upenn-embedded/final-project-website-submission-f25-t28-f25-minus-5/Slides/ESE5190 F25 Final Project Proposals.pptx.pdf

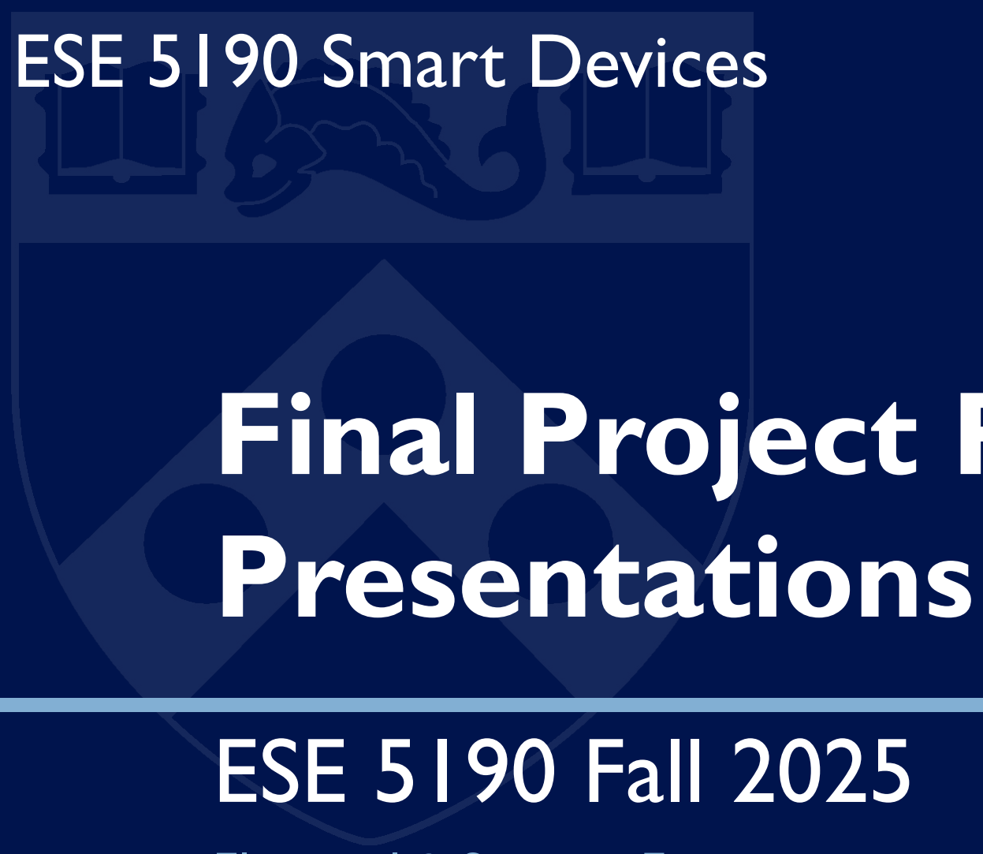
[picture p5: figure]
Presentations; ESE 5190 Fall 2025; ESE 5190 Smart Devices

# Final Project Proposal

Electrical & Systems Engineering University of Pennsylvania

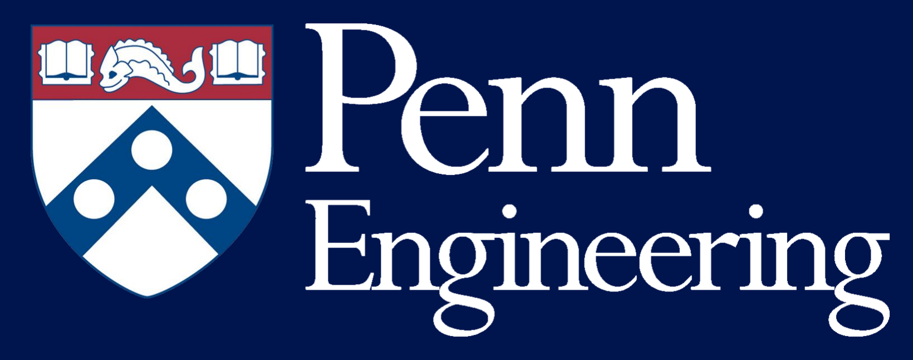
[picture p6: figure]

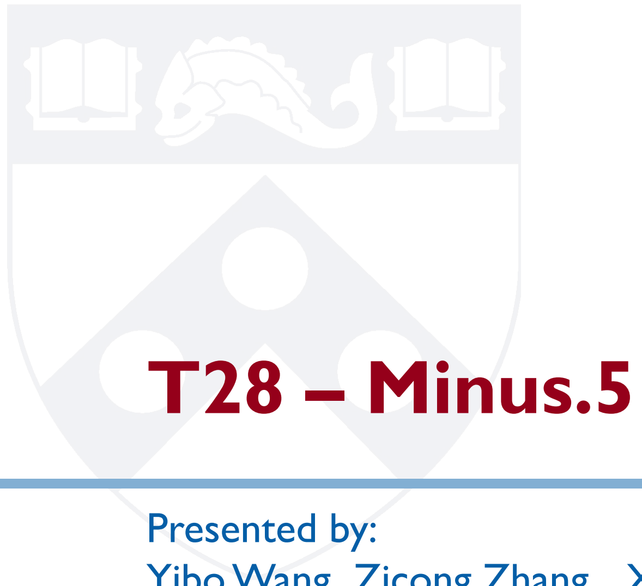
[picture p7: figure]
T28 – Minus.5; Presented by:

### Yibo Wang Zicong Zhang Xiuwen Zheng

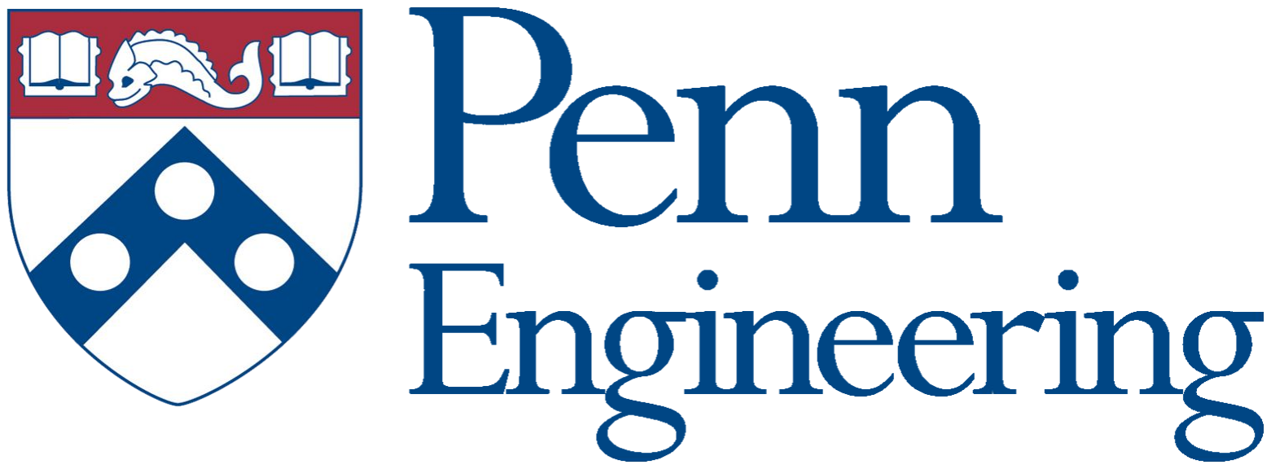
[picture p8: figure]

# Questions!

### How many people know what is a guitar?

### How many of you know how to play a guitar?

## Can you imagine that you could play guitar solos and sing along —without ever learning a single chord?

# Now!

# Making the impossible possible!

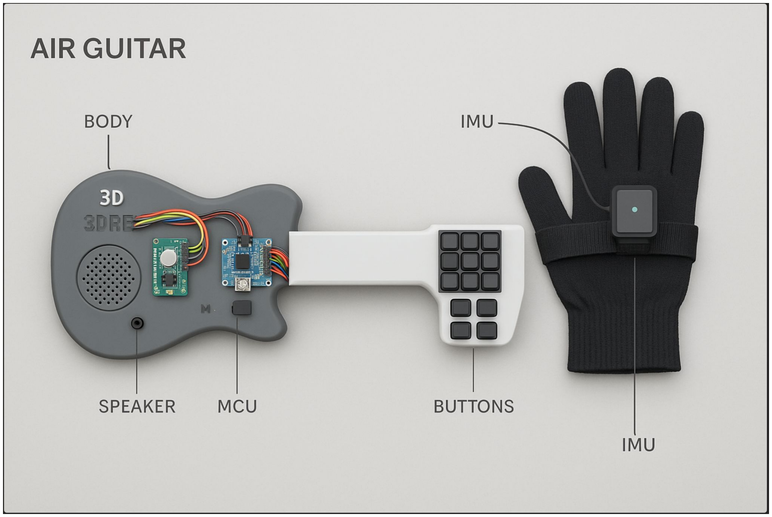
[picture p9: figure]

## The AirGuitar

# We shall introduce to you

Notice:
AI-generated concept rendering. Final appearance subject to physical build and implementation.

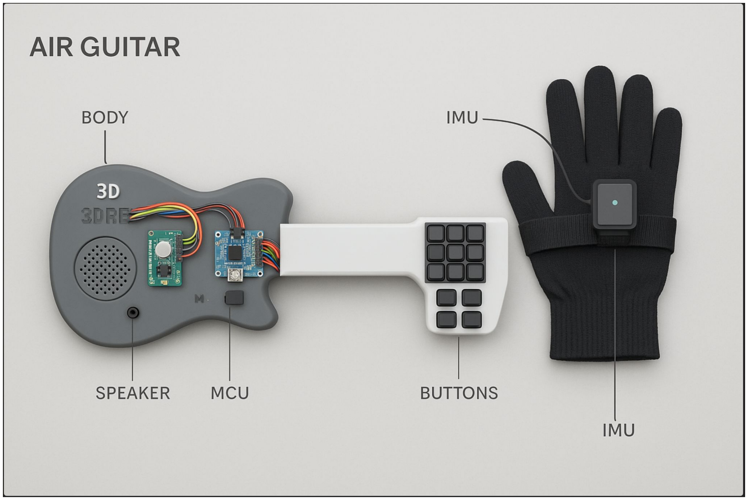
[picture p10: figure]

## The AirGuitar

# We shall introduce to you

Simplifies everything:

- Fixed chord mappings

—always makes great
sound

## The AirGuitar

# We shall introduce to you

Simplifies everything:

- IMU-based
strumming—natural
gestures, no strings
required.

## The AirGuitar

# We shall introduce to you

Simplifies everything:

- “Auto-play” key—press
once to auto-cycle
chords and sing along.

## The AirGuitar

# We shall introduce to you

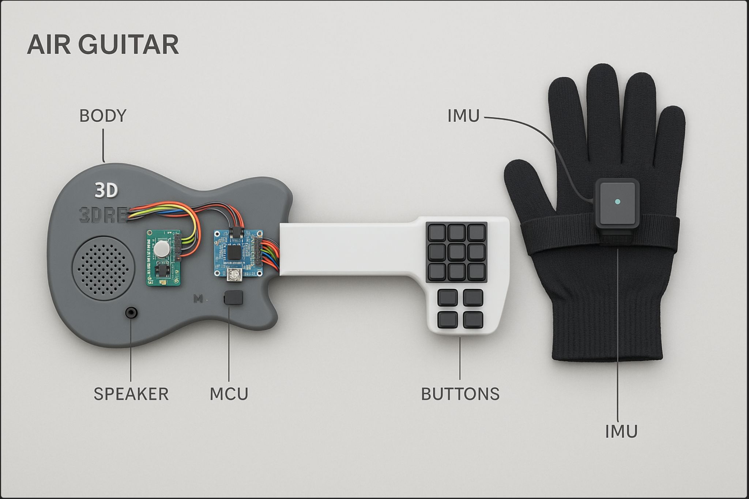
[picture p11: figure]

## Simple!

## Accessible!

## Fun!

## Music for everyone!

# New Era for enjoying music!

Low-cost on-ramp to
music-making; less
pressure, more joy.

Useful for music
education, therapy, and
quick prototyping of song
ideas.

Socially sticky: instant
accompaniment for
singers;
yes, potentially a low-effort way to “impress your
crush.

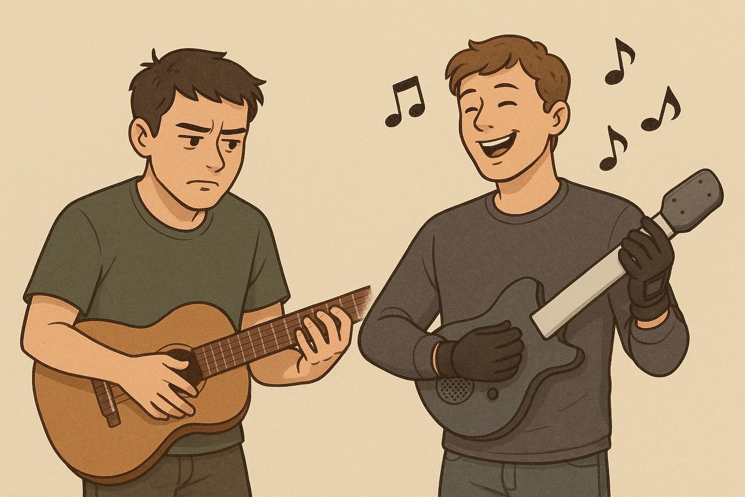
[picture p12: figure]

## Accessible, Interactive, Creative, and Inspirational

—turn hesitation into participation.

# System Block Diagram

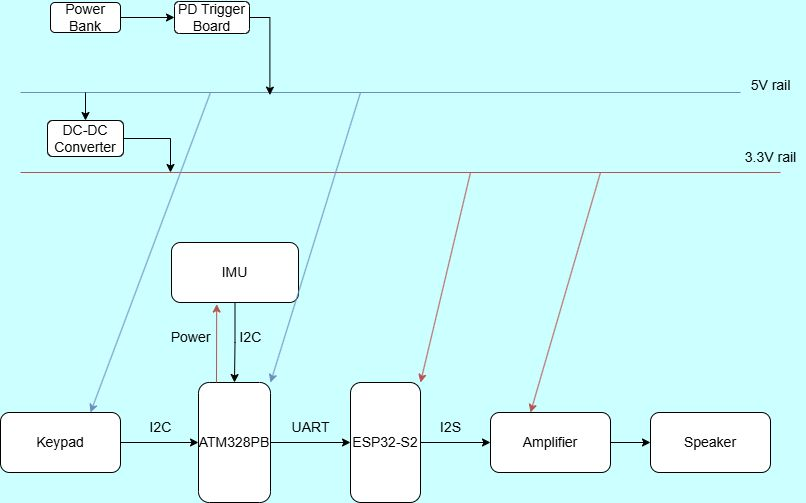
[picture p13: figure]

Input Side

- Keypad (I²C) → chord selection
- IMU (I²C) → detects strumming gestures
- ATmega328PB → processes both inputs and sends data to ESP32 via UART

Output Side

- ESP32-S2 → generates corresponding guitar sounds
- I²S → digital audio to amplifier, then speaker

Power

- 5V output from PD trigger board, regulated to 3.3V via Buck-Boost.

# Play a compact, light, portable “Guitar”

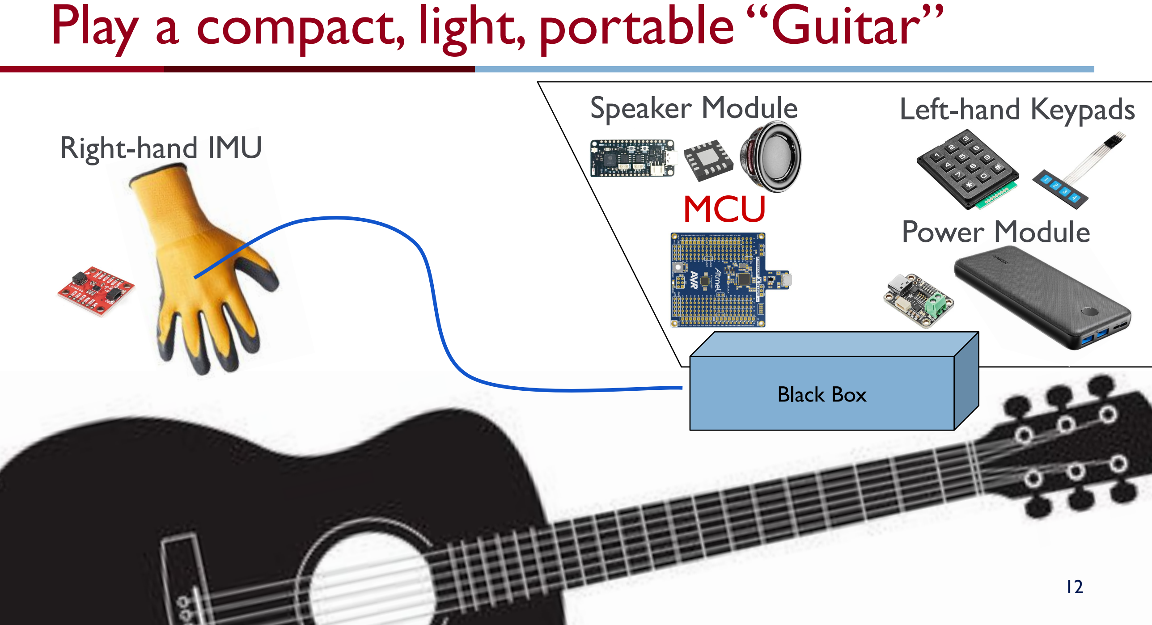
[picture p14: page 12]

### Right-hand IMU

### Speaker Module

## MCU

### Left-hand Keypads

### Power Module

Black Box

# Play it without knowing how to play the guitar

Right-hand IMU | Left-hand Keypads

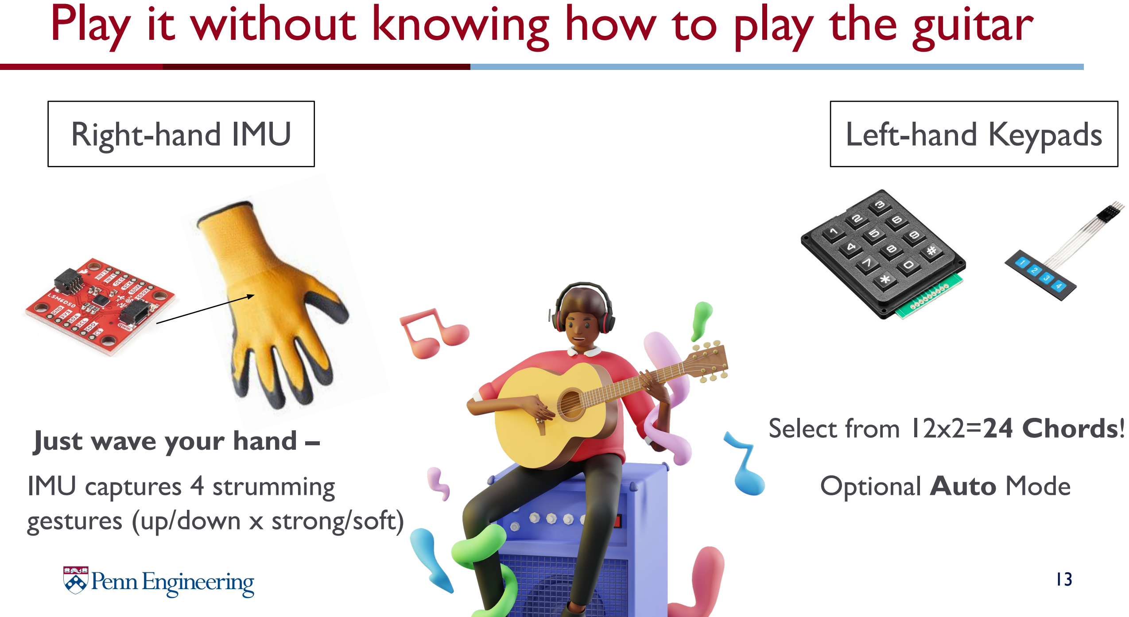
[picture p15: page 13]

Select from 12x2=24 Chords!

| Optional Auto Mode

Just wave your hand –
IMU captures 4 strumming
gestures (up/down x strong/soft)

# Inspire your friends with high-quality music!

## Speaker Module

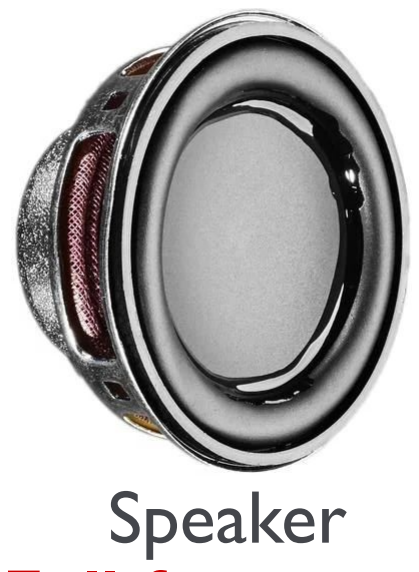
[picture p16: figure]
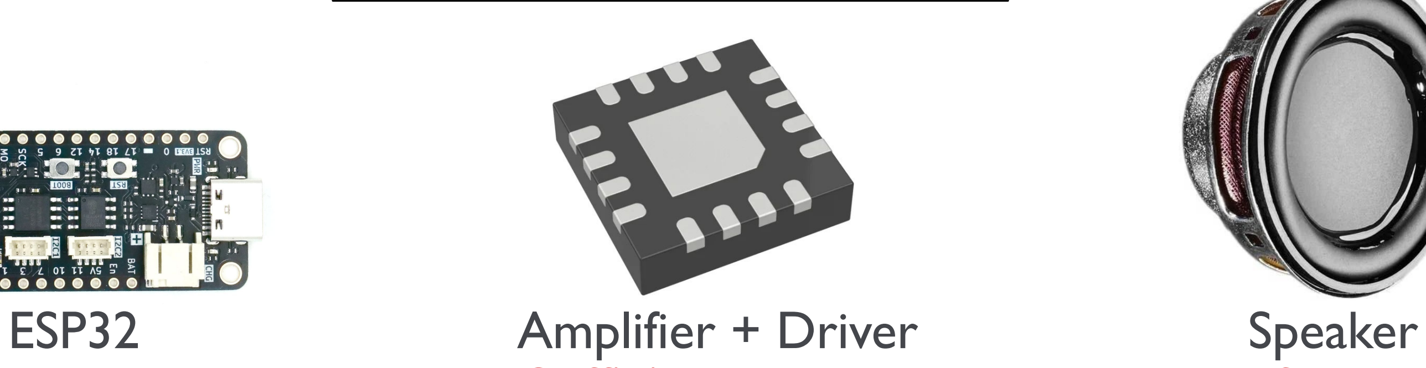
[picture p17: figure]
ESP32; Amplifier + Driver; Speaker
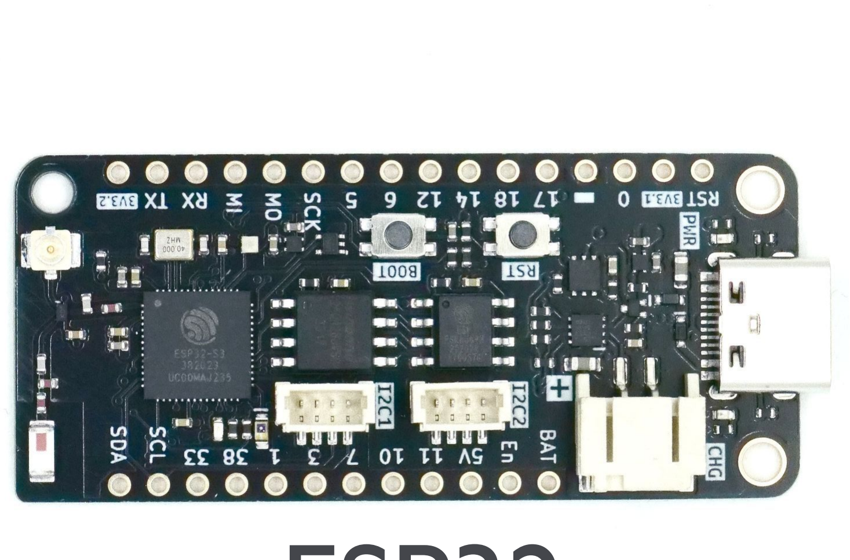
[picture p18: figure]

Low latency | Sufficient Volume | Full-frequency

### Amy: A Music Synthesizer Library

Emulate sound of a real guitar

Simple.
Effective.
Transformative.

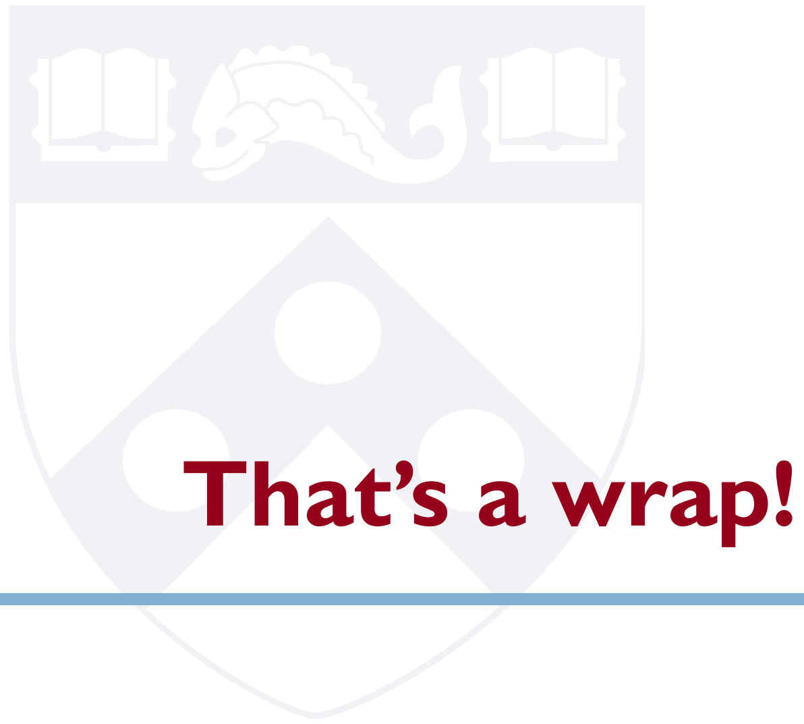
[picture p19: figure]
That’s a wrap!
