upenn-embedded/final-project-website-submission-f25-t28-f25-minus-5/Miscellaneous/Guitar Sheets/Beyond/IMG_2863.jpg

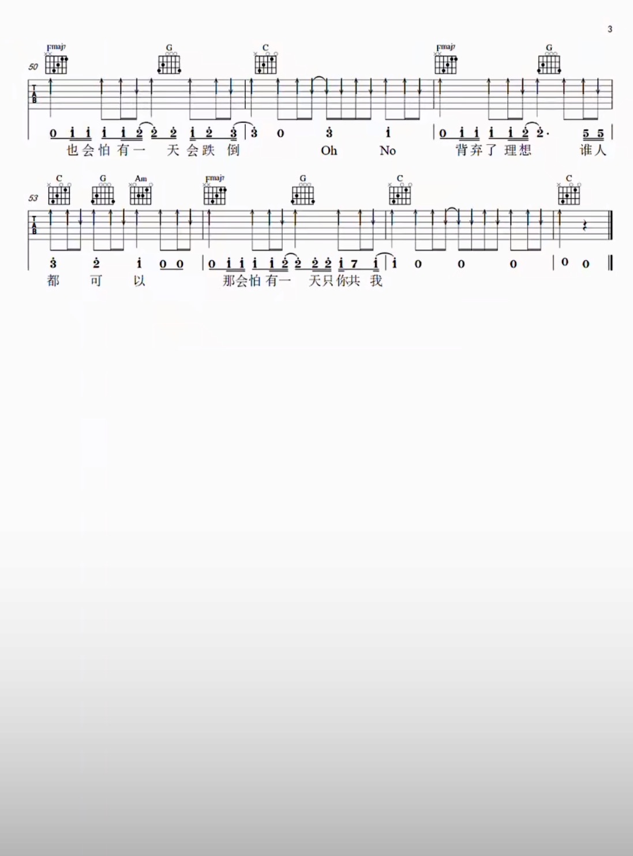
Miscellaneous/Guitar Sheets/Beyond/IMG_2863.jpg
