upenn-embedded/final-project-website-submission-f25-t28-f25-minus-5/Miscellaneous/Guitar Sheets/Jay Chow/IMG_2865.PNG

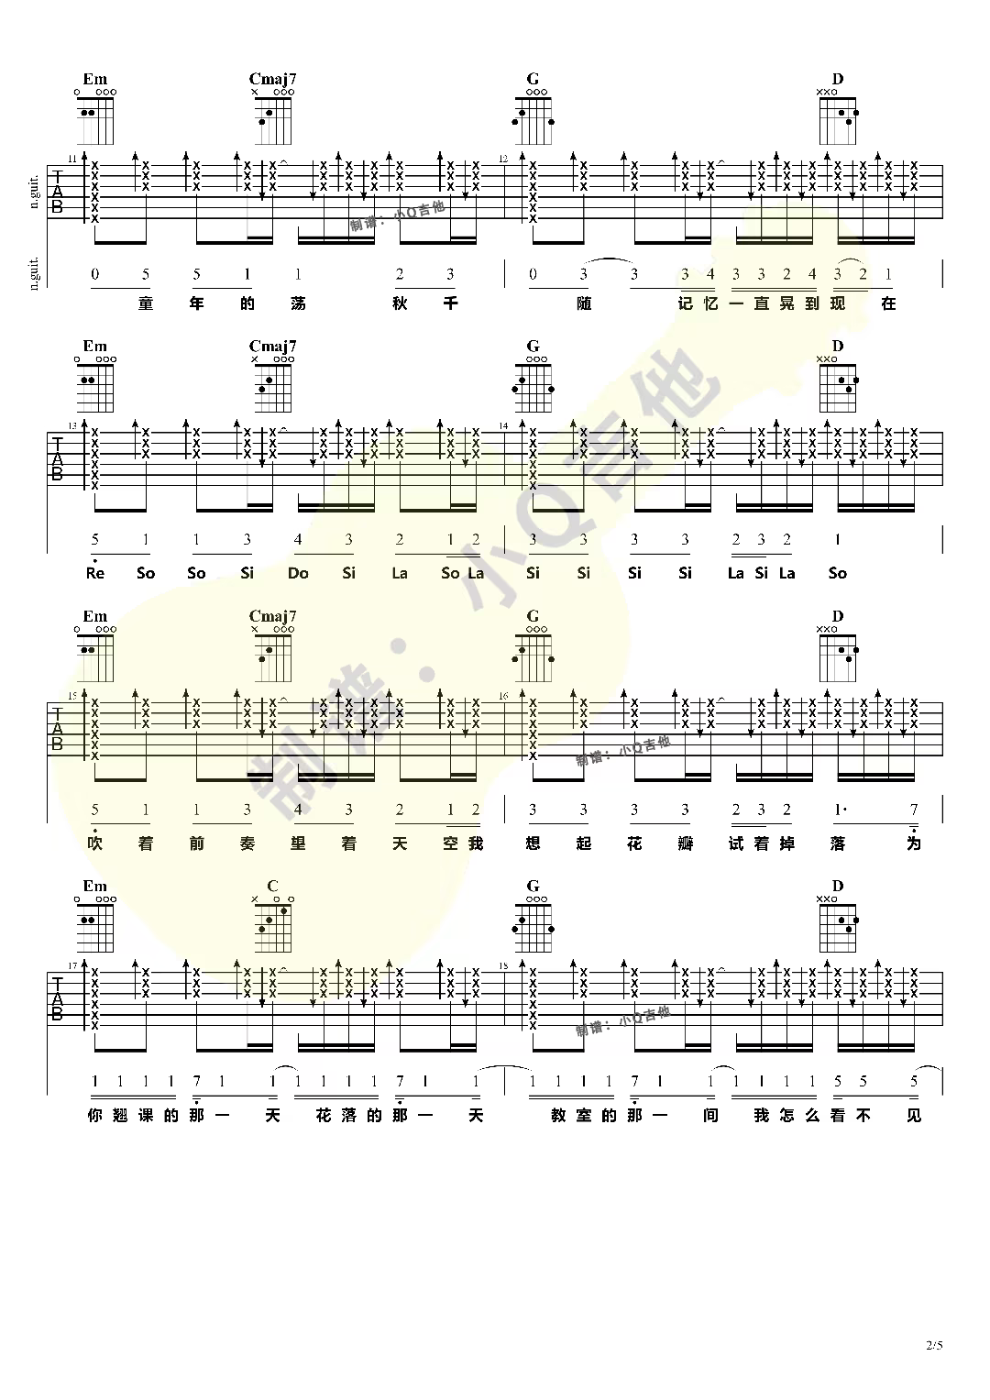
Miscellaneous/Guitar Sheets/Jay Chow/IMG_2865.PNG
