upenn-embedded/final-project-website-submission-f25-t28-f25-minus-5/Miscellaneous/Guitar Sheets/Jay Chow/IMG_2870.jpg

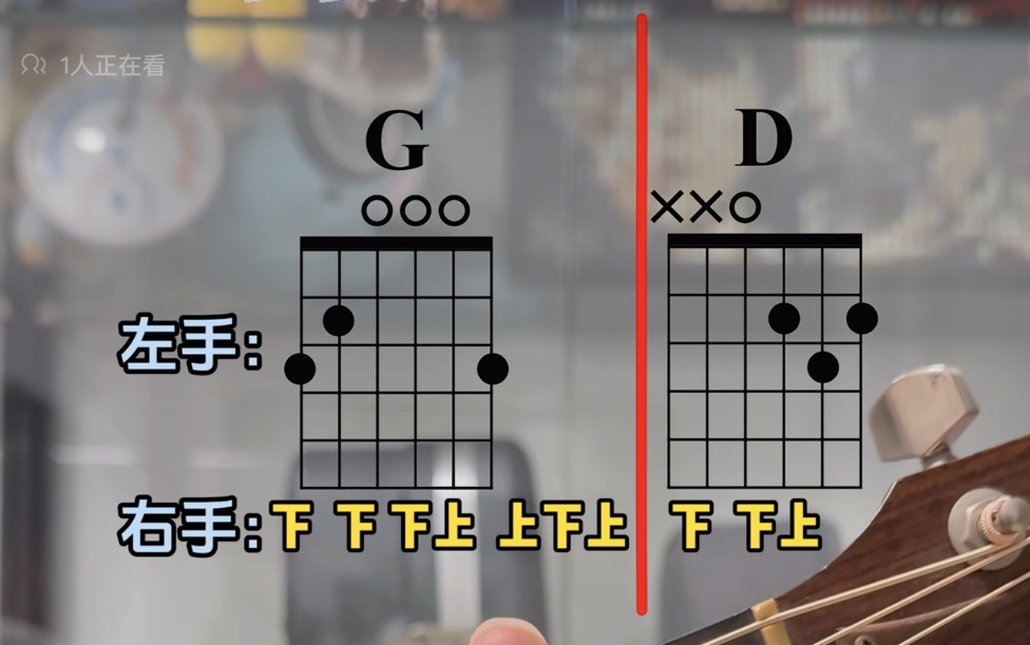
Miscellaneous/Guitar Sheets/Jay Chow/IMG_2870.jpg
