upenn-embedded/final-project-website-submission-f25-t28-f25-minus-5/ESE5190 F25 Final Project BOM.xlsx

Sheet: Template (Example)
Team Number | 0
Team Name | zer0th bit
 | Name | Email | GitHub Handle
Team Member # 1 | James W. | james@seas.upenn.edu | electret03
Team Member # 2 | Annie E. | annie@seas.upenn.edu | spacecadet
Team Member # 3 |  |  |  |  |  |  | Total Cost
Row of totals |  |  |  |  |  |  | $62.40
Part Role | Part Description | Manufacturer | Manufacturer part number (MPN) | Interface to MCU | MCU Pins Assigned | Distributor | Cost per device | URL | Comments
Processor | Main Processor | Microchip | ATmega328PB Xplained Mini | N/A | N/A |  | $0.00 |  | Already included in kit
Sensor (Input) | 8 x Channel 12-bit I2C DAC | Adafruit | 6223 | I2C | PE0, PE1 | Adafruit | $24.95 | https://www.adafruit.com/product/6223
Actuator (Output) | Motor Driver | Adafruit | 3190 | PWM | PD0, PD2 | DigiKey | $7.50 | https://www.digikey.com/en/products/detail/adafruit-industries-llc/3190/6138098
Actuator (Output) | 2.8" TFT LCD | Adafruit | 1770 | SPI | PB2, PB3, PB4, PB5 | Mouser | $29.95 | https://www.mouser.com/ProductDetail/Adafruit/1770?qs=GURawfaeGuAO3ABjFNxilQ%3D%3D

Sheet: Template (For you!)
Team Number
Team Name
 | Name | Email | GitHub Handle
Team Member # 1
Team Member # 2
Team Member # 3 |  |  |  |  |  |  | Total Cost
Row of totals |  |  |  |  |  |  | $0.00
Part Role | Part Description | Manufacturer | Manufacturer part number (MPN) | Interface to MCU | MCU Pins Assigned | Distributor | Cost per device | URL | Comments
