upenn-embedded/final-project-website-submission-f25-t28-f25-minus-5/Miscellaneous/Case Design/Measurement.pdf

儻

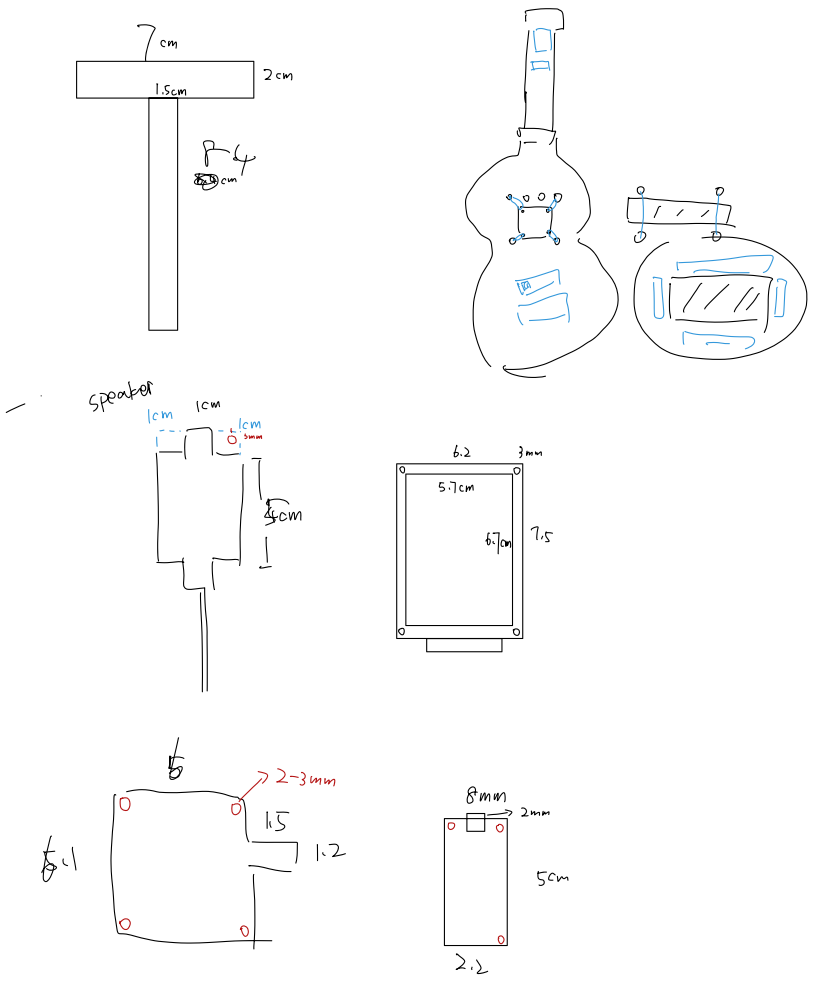
[picture p30: page 1]
iiiii; iii 上1 2 3mm; Üin

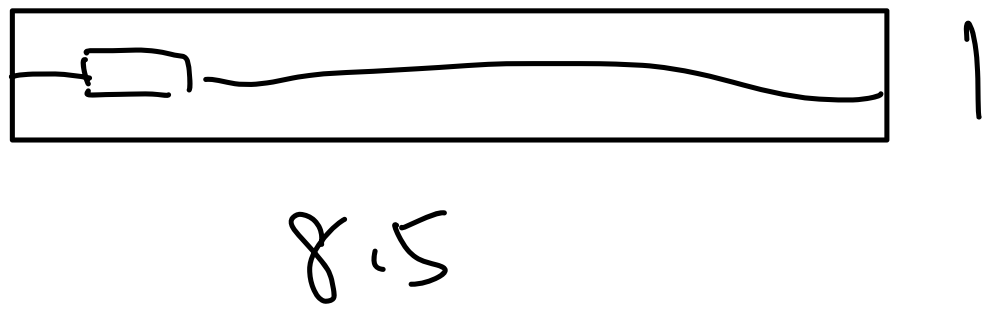
[picture p31: page 2]
