upenn-embedded/final-project-website-submission-f25-t28-f25-minus-5/Atmega/i2c/i2c.h

#ifndef I2C_H
#define I2C_H

#include <stdint.h>

void i2c_init(void);
void i2c_start(uint8_t addr);
void i2c_write(uint8_t data);
uint8_t i2c_read_ack(void);
uint8_t i2c_read_nack(void);
void i2c_stop(void);

#endif
